korigod/clever-card/kicad/kicad.kicad_pcb

## KiCad design kicad/kicad.kicad_pcb (2019-04-13)

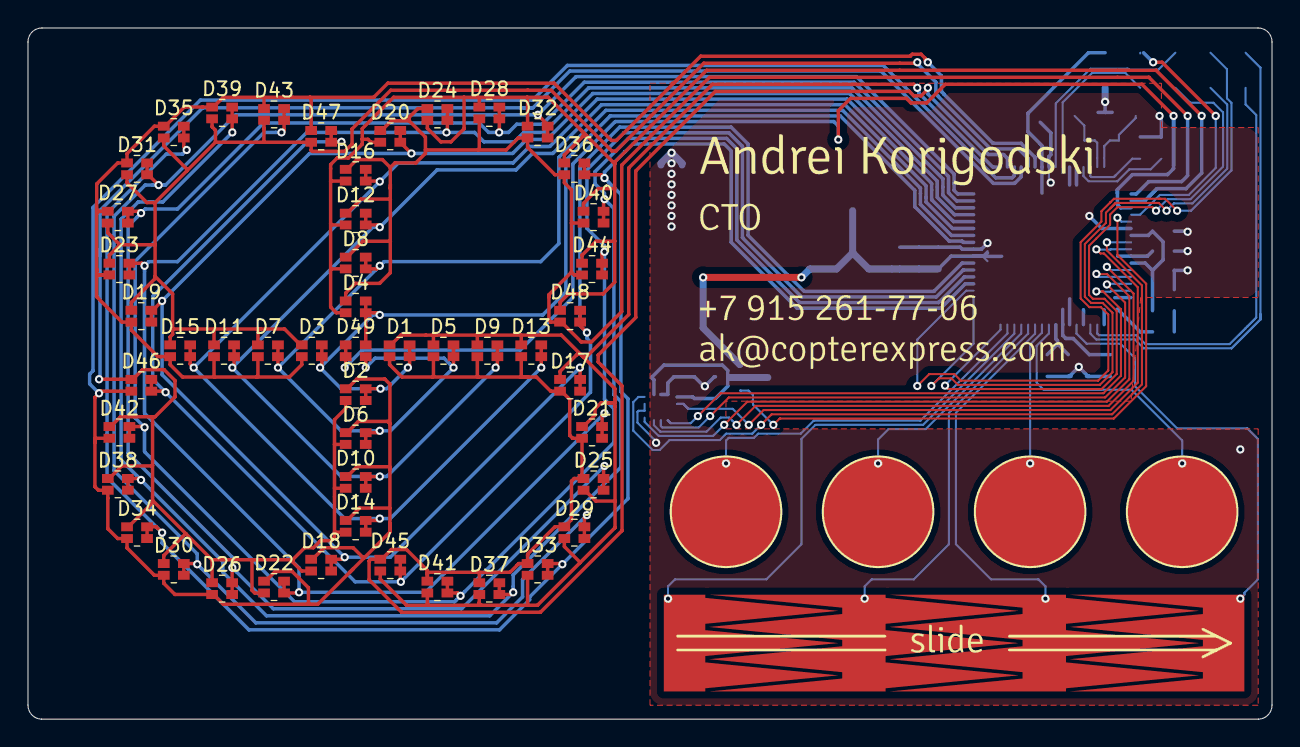
[picture p1: board kicad.kicad_pcb from above]

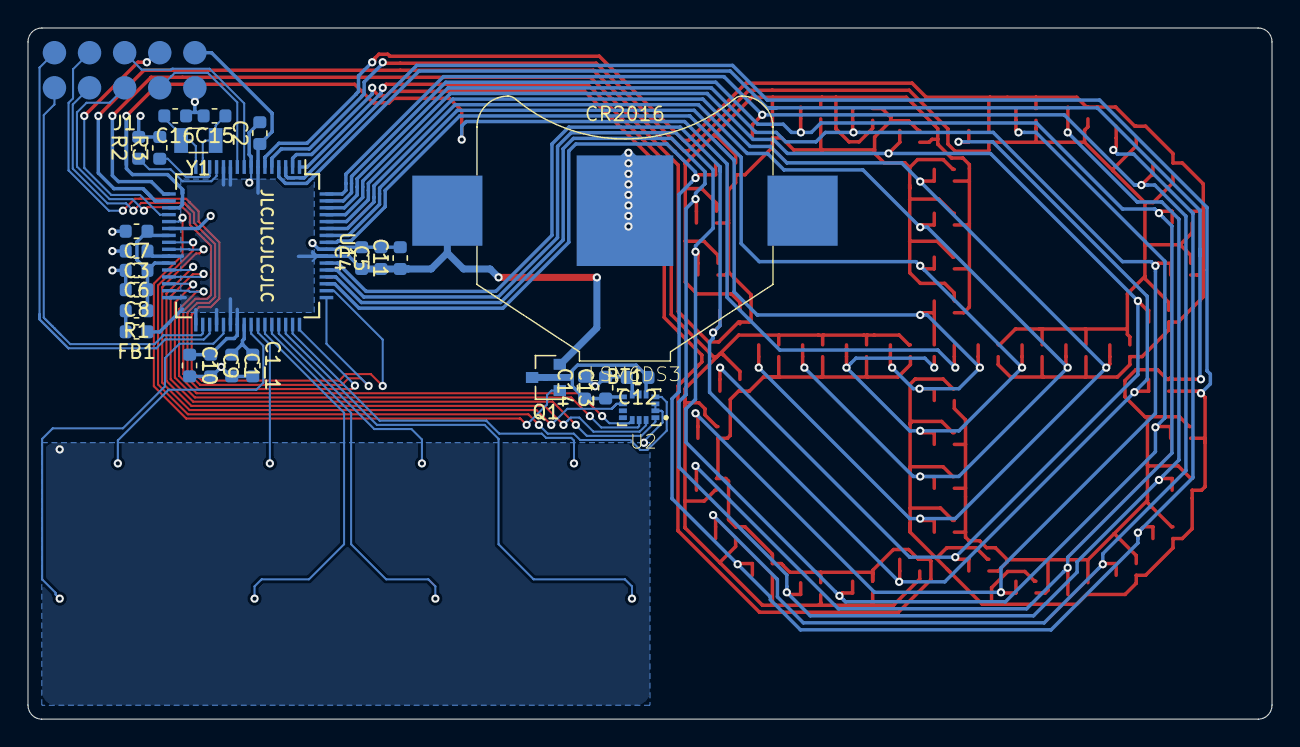
[picture p2: board kicad.kicad_pcb from below]

Board: 2 copper layers, 90.0 x 50.0 mm, 85 parts (27 on the bottom side), 54 nets.

Parts:
BT1: Battery_Cell; BatteryHolder_Keystone_3026_1x2016
C1, C5: 1uF; C_0603_1608Metric
C1_1, C8, C10, C14: 10uF; C_0603_1608Metric
C2, C3, C4, C9, C12, C13: 0.1uF; C_0603_1608Metric
C6, C7: 10nF; C_0603_1608Metric
C11: 47uF; C_0603_1608Metric
C15, C16: 22pF; C_0603_1608Metric
D1, D2, D3, D4, D5, D6, D7, D8, D9, D10, D11, D12, D13, D14, D15, D16, D17, D18, D19, D20, D21, D22, D23, D24, D25, D26, D27, D28, D29, D30, D31, D32, D33, D34, D35, D36, D37, D38, D39, D40, D41, D42, D43, D44, D45, D46, D47, D48, D49: LED_Dual_AACC; LED_DUAL_0606
FB1: Ferrite_Bead_Small; L_0603_1608Metric
J1: POGO_10PADS; TestPoints_2x05_P2.54_D1.7
Q1: Q_PMOS_GSD; SOT-23
R1: 1; R_0603_1608Metric
R2, R3: 0; R_0603_1608Metric
TS1, TS2, TS3, TS4: TOUCH_PAD; TouchPad_D8.0mm
TS5: TOUCH_SLIDER_4PADS; TouchSlider-4_42x7mm
U1: EFM32LG232F64; LQFP-64_10x10mm_P0.5mm
U2: LSM6DS3
Y1: 32768Hz; Crystal_SMD_3215-2Pin_3.2x1.5mm
svg2mod: G***; Text_Slide_Signika_Cu
svg2mod#2: G***; Text_Position_SilkS
svg2mod#3: G***; Text_Contacts_Reversed-2_SilkS
svg2mod#4: G***; Text_Name_without-i-dot_9.5pt_SilkS

Connections:
GND: BT1.2, C1.2, C1_1.2, C2.2, C3.2, C4.2, C5.2, C6.2, C7.2, C8.2, C9.2, C10.2, C11.2, C12.2, C13.2, C14.2, C15.2, C16.2, J1.2, R2.2, R3.2, U1.8, U1.22, U1.56, U2.2, U2.3, U2.6, U2.7
IMU_VDD: C12.1, C13.1, C14.1, Q1.3, U2.5, U2.8
LED_A0: D1.1, D5.1, D9.1, D13.1, D17.1, D21.1, D25.2, D29.2, D33.2, D37.2, D41.2, D45.2, U1.1
LED_A1: D1.2, D5.2, D9.2, D13.2, D17.2, D21.2, D25.1, D29.1, D33.1, D37.1, D41.1, D45.1, U1.2
LED_A2: D2.1, D6.1, D10.1, D14.1, D18.1, D22.1, D26.2, D30.2, D34.2, D38.2, D42.2, D46.2, U1.3
LED_A3: D2.2, D6.2, D10.2, D14.2, D18.2, D22.2, D26.1, D30.1, D34.1, D38.1, D42.1, D46.1, U1.4
LED_A4: D3.1, D7.1, D11.1, D15.1, D19.1, D23.1, D27.2, D31.2, D35.2, D39.2, D43.2, D47.2, U1.5
LED_A5: D3.2, D7.2, D11.2, D15.2, D19.2, D23.2, D27.1, D31.1, D35.1, D39.1, D43.1, D47.1, U1.6
LED_A6: D4.1, D8.1, D12.1, D16.1, D20.1, D24.1, D28.2, D32.2, D36.2, D40.2, D44.2, D48.2, U1.17
LED_A7: D4.2, D8.2, D12.2, D16.2, D20.2, D24.2, D28.1, D32.1, D36.1, D40.1, D44.1, D48.1, U1.18
LED_A8: D49.1, D49.2, U1.19
LED_K0: D1.3, D1.4, D2.3, D2.4, D3.3, D3.4, D4.3, D4.4, D49.3, U1.57
LED_K1: D5.3, D5.4, D6.3, D6.4, D7.3, D7.4, D8.3, D8.4, D49.4, U1.58
LED_K2: D9.3, D9.4, D10.3, D10.4, D11.3, D11.4, D12.3, D12.4, U1.59
LED_K3: D13.3, D13.4, D14.3, D14.4, D15.3, D15.4, D16.3, D16.4, U1.60
LED_K4: D17.3, D17.4, D18.3, D18.4, D19.3, D19.4, D20.3, D20.4, U1.61
LED_K5: D21.3, D21.4, D22.3, D22.4, D23.3, D23.4, D24.3, D24.4, U1.62
LED_K6: D25.3, D25.4, D26.3, D26.4, D27.3, D27.4, D28.3, D28.4, U1.63
LED_K7: D29.3, D29.4, D30.3, D30.4, D31.3, D31.4, D32.3, D32.4, U1.64
LED_K8: D33.3, D33.4, D34.3, D34.4, D35.3, D35.4, D36.3, D36.4, U1.51
LED_K9: D37.3, D37.4, D38.3, D38.4, D39.3, D39.4, D40.3, D40.4, U1.52
LED_K10: D41.3, D41.4, D42.3, D42.4, D43.3, D43.4, D44.3, D44.4, U1.53
LED_K11: D45.3, D45.4, D46.3, D46.4, D47.3, D47.4, D48.3, D48.4, U1.54
LFXTAL_N: C16.1, U1.16, Y1.2
LFXTAL_P: C15.1, U1.15, Y1.1
MCU_AVDD: C6.1, C7.1, C8.1, R1.2, U1.23, U1.27
unnamed: C1.1, C1_1.1, U1.40
unnamed: FB1.2, R1.1
unnamed: J1.3, U1.20
unnamed: J1.4, U1.10
unnamed: J1.5, U1.9
unnamed: J1.6, U1.48
unnamed: J1.7, U1.50
unnamed: J1.8, U1.49
unnamed: J1.9, U1.35
unnamed: J1.10, U1.34
unnamed: Q1.1, U1.21
unnamed: U1.29, U2.1
unnamed: U1.28, U2.14
unnamed: U1.30, U2.13
unnamed: U1.31, U2.12
unnamed: U1.24, U2.4
unnamed: U1.25, U2.9
unnamed: TS5.1, U1.46
unnamed: TS5.2, U1.44
unnamed: TS5.3, U1.43
unnamed: TS5.4, U1.37
unnamed: R2.1, U1.13
unnamed: R3.1, U1.14
TOUCH_PAD0: TS1.1, U1.47
TOUCH_PAD1: TS2.1, U1.45
TOUCH_PAD2: TS3.1, U1.42
TOUCH_PAD3: TS4.1, U1.41
VDD: BT1.1, C2.1, C3.1, C4.1, C5.1, C9.1, C10.1, C11.1, FB1.1, J1.1, Q1.2, U1.7, U1.11, U1.12, U1.26, U1.32, U1.33, U1.36, U1.38, U1.39, U1.55
