korigod/clever-card/test-jig/layout/test-jig.kicad_pcb

## KiCad design test-jig/layout/test-jig.kicad_pcb (2020-01-29)

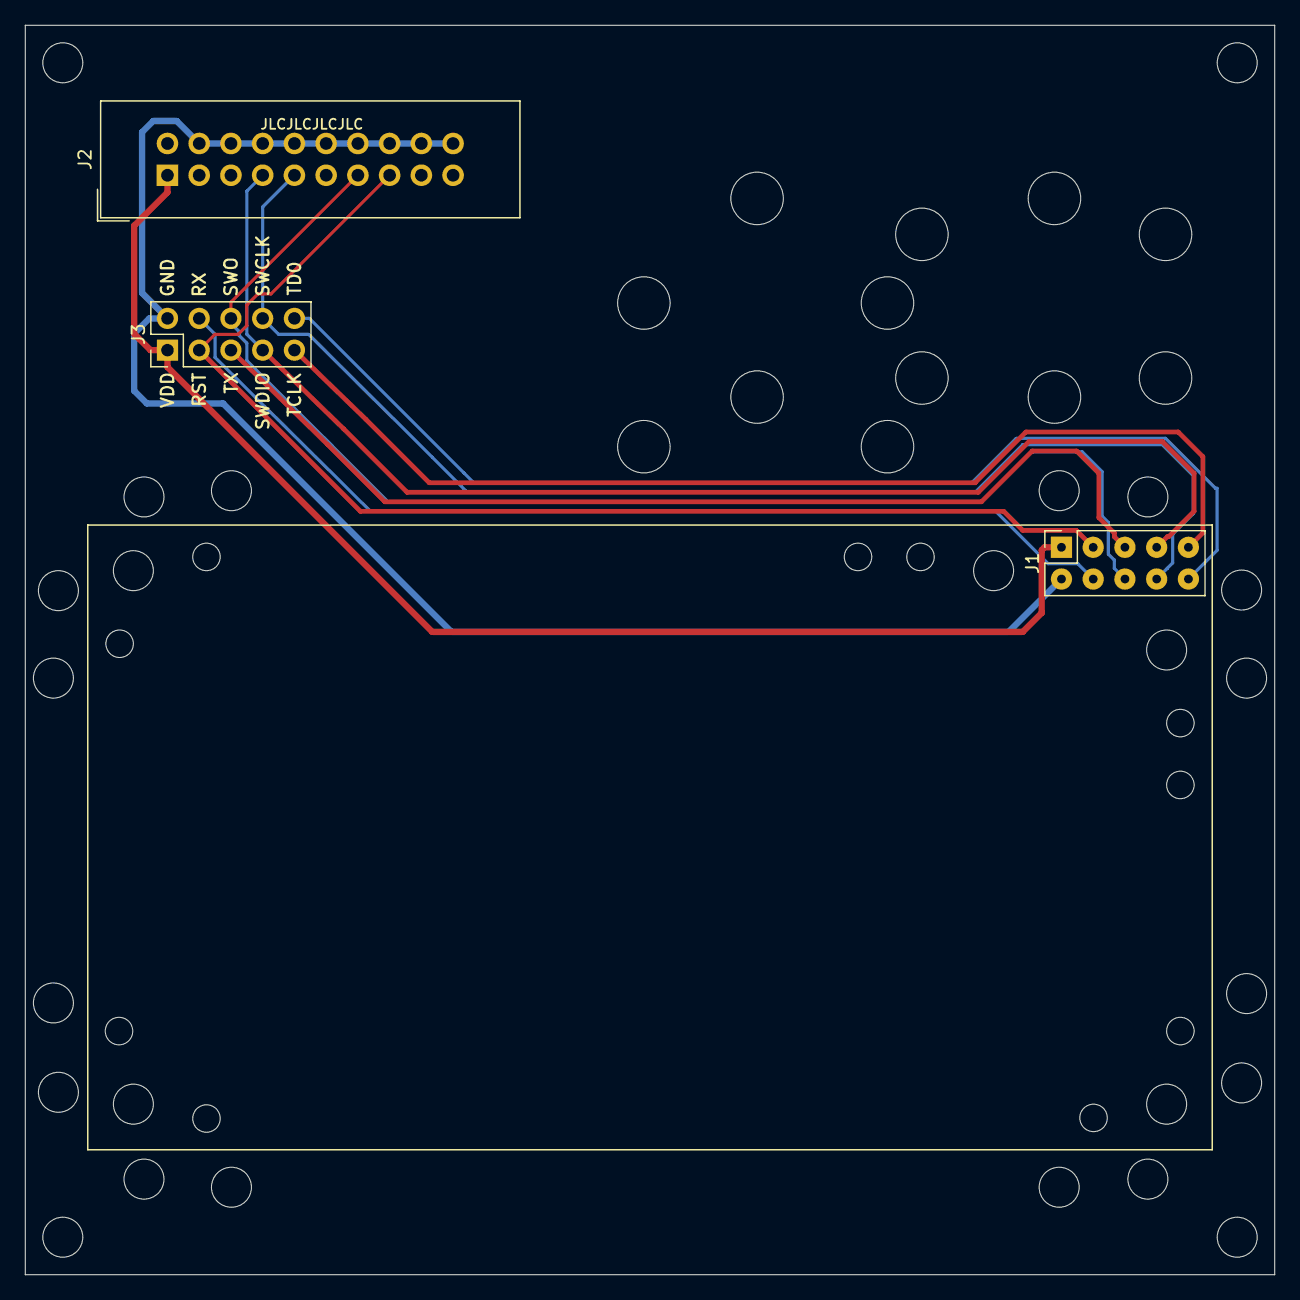
[picture p3: board test-jig.kicad_pcb from above]

Board: 2 copper layers, 100.0 x 100.0 mm, 3 parts (0 on the bottom side), 10 nets.

Parts:
J1: Conn_02x05_Odd_Even; PinHeader_2x05_P2.54mm_D0.7mm_Vertical
J2: Conn_02x10_Odd_Even; IDC-Header_2x10_P2.54mm_Vertical
J3: Conn_02x05_Odd_Even; PinHeader_2x05_P2.54mm_Vertical

Connections:
DBG_SWCLK: J1.8, J2.9, J3.8
DBG_SWDIO: J1.7, J2.7, J3.7
DBG_SWO: J1.6, J2.13, J3.6
ETM_TCLK: J1.9, J3.9
ETM_TD0: J1.10, J3.10
GND: J1.2, J2.4, J2.6, J2.8, J2.10, J2.12, J2.14, J2.16, J2.18, J2.20, J3.2
RESET: J1.3, J2.15, J3.3
USART_RX: J1.4, J3.4
USART_TX: J1.5, J3.5
VDD: J1.1, J2.1, J3.1
