korigod/clever-card/firmware/src/debug_hooks.c

#include "FreeRTOS.h"
#include "task.h"

#define TASK_STATUSES_ARRAY_SIZE 8

TaskStatus_t taskStatuses[TASK_STATUSES_ARRAY_SIZE];

void vApplicationIdleHook(void) {
	uxTaskGetSystemState(taskStatuses, TASK_STATUSES_ARRAY_SIZE, NULL);
}

void vApplicationStackOverflowHook(TaskHandle_t xTask, signed char *pcTaskName) {
	configASSERT(0);
}

void vApplicationMallocFailedHook(void) {
	configASSERT(0);
}

__attribute__((weak)) void vApplicationTickHook(void) {
	// This hook is redefined when testing on target device
}
