korigod/clever-card/firmware/src/static_alloc.c

#include "FreeRTOSConfig.h"
#include "FreeRTOS.h"


/* configSUPPORT_STATIC_ALLOCATION is set to 1, so the application must provide an
implementation of vApplicationGetIdleTaskMemory() to provide the memory that is
used by the Idle task. */
void vApplicationGetIdleTaskMemory(StaticTask_t **ppxIdleTaskTCBBuffer,
                                   StackType_t **ppxIdleTaskStackBuffer,
                                   uint32_t *pulIdleTaskStackSize)
{
	static StaticTask_t xIdleTaskTCB;
	static StackType_t uxIdleTaskStack[configMINIMAL_STACK_SIZE];

	*ppxIdleTaskTCBBuffer = &xIdleTaskTCB;
	*ppxIdleTaskStackBuffer = uxIdleTaskStack;
	*pulIdleTaskStackSize = configMINIMAL_STACK_SIZE;
}


/* configSUPPORT_STATIC_ALLOCATION and configUSE_TIMERS are both set to 1, so the
application must provide an implementation of vApplicationGetTimerTaskMemory()
to provide the memory that is used by the Timer service task. */
void vApplicationGetTimerTaskMemory(StaticTask_t **ppxTimerTaskTCBBuffer,
                                    StackType_t **ppxTimerTaskStackBuffer,
                                    uint32_t *pulTimerTaskStackSize)
{
	static StaticTask_t xTimerTaskTCB;
	static StackType_t uxTimerTaskStack[configTIMER_TASK_STACK_DEPTH];

	*ppxTimerTaskTCBBuffer = &xTimerTaskTCB;
	*ppxTimerTaskStackBuffer = uxTimerTaskStack;
	*pulTimerTaskStackSize = configTIMER_TASK_STACK_DEPTH;
}
