korigod/clever-card/(commit log)

2019-03-18 schematics: initial revision
2019-03-18 led_pattern_gen: initial revision
2019-03-22 schematics: update card
2019-03-22 footprints: add red-green dual LED
2019-03-22 schematics: decouple MCU and use red-green LEDs
2019-03-23 schematics: connect power to MCU
2019-03-23 schematics: generate LED matrix
2019-03-24 schematics: check if specified LED count achieved
2019-03-24 schematics: add capacitive touch pads
2019-03-24 schematics: add IMU power connections
2019-03-24 pins: add file with pin assignments
    [pins.csv]
2019-03-24 pins: separate pin and assignment with tabs
    [pins.csv]
2019-03-24 schematics: add 32768 Hz crystal
2019-03-24 schematics: add SPI and INT lines between MCU and IMU
    [pins.csv]
2019-03-24 pins: update pin assignment to add one more LED line
    [pins.csv]
2019-03-24 schematics: connect LED matrix to MCU
2019-03-24 schematics: use ERC (electrical rule check)
2019-03-25 schematics: suppress "Insufficient drive" ERC warning
2019-03-25 schematics: connect capacitive sense pads
2019-03-25 schematics: specify the crystal footprint
2019-03-25 schematics: add debug and programming interface
2019-03-25 schematics: specify correct footprint for battery holder
    It's fully compatible with Keystone 3028.
2019-03-25 schematics: update footprints according to KiCad 5 Device library
2019-03-26 footprints: add LSM6DS3
2019-03-27 footprints: rename LSM6DS3
2019-03-28 footprints: add touch slider generated by wizard
2019-03-28 gitignore: add kicad autosave files
2019-03-28 footprints: fix name of LSM6DS3
2019-03-28 schematics: fix LED footprint name
2019-03-29 schematics: connect unused EFM32 pins to circuit common
2019-03-29 footprints: add capacitive touch pad
2019-03-29 footprints: generate touch slider with my new python tool
2019-03-30 footprints: add debug/programming pads for spring loaded connector
2019-03-31 led_pattern: move matplotlib plotting and GUI to separate module
2019-04-01 led_pattern: rename led_pattern_gen to led_pattern
2019-04-01 led_pattern: improve readability
2019-04-01 led_pattern: fix calculations in case linear_radius != 1
2019-04-01 led_pattern: swap linear leds to make layout easier
2019-04-02 footprints: improve touch slider
2019-04-03 footprints: add new generated footprint for CR2016 holder
2019-04-03 schematics: modify LED connection
2019-04-03 schematics: swap touch slider pins to make layout easier
2019-04-03 led_pattern: fix LED arcs generation
2019-04-03 led_pattern: add pcbnew script for automated layout
2019-04-03 schematics: add oscillator load capacitors
2019-04-03 schematics: add larger IMU decoupling capacitor
2019-04-03 schematics: swap LED pins to simplify layout
2019-04-04 schematics: simplify MCU analog power decoupling
2019-04-04 schematics: connect unused pins to power instead of ground
    It makes layout easier
2019-04-06 schematics: assign names to crystal nets
    It enables KiCad differential pair length matching tools.
2019-04-06 schematics: pass ground net for unused IMU pins as arg
2019-04-06 schematics: fix unused pins handling message
2019-04-06 schematics: swap touch sense pins to make layout simpler
2019-04-06 schematics: add P-MOSFET to cut IMU power
    It consumes several uA even when disabled.
    [pins.csv]
2019-04-07 schematics: decouple MCU_AVDD better
    This reverts commit 16f4ae7.
2019-04-07 schematics: change IMU power mosfet pin
    [pins.csv]
2019-04-08 led_pattern: make compatible with python 2
    KiCad uses python 2.7.
2019-04-09 schematics: specify debug pads ref_prefix
2019-04-09 schematics: modify MCU power decoupling
2019-04-09 footprints: update battery holder footprint
2019-04-09 footprints: update LED footprint
2019-04-10 footprints: add silkscreen circle to touch button
2019-04-10 footprints: add touch button with circle in mask layer
2019-04-13 kicad: first manufactured revision
    [clever-JLC-label-silkscreen-placeholder.kicad_pcb, clever-for-gold-plating_all-text-on-mask.kicad_pcb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]
2019-04-14 BOM: first revision
    [BOM.csv]
2019-04-16 pins: remove outdated pin assignment doc
2019-04-16 components: remove unused RGB led
2019-07-05 firmware-experimental: first revision of LSM6DS3 test project
    EFM32LG-STK3600 dev board is used.
2019-07-06 firmware-experimantal: use DMA for SPI transfer
2019-07-07 pins: clarify the assignment
    IMU_FET is the gate of the N-MOSFET which cuts LSM6DS3's power
    when it's not in use to minimize power consumption.
    [pins.csv]
2019-07-07 led_pattern: fix variables names
2019-07-08 firmware: remove LED-control test code
2019-07-08 firmware: update statuses of tasks in idle hook
    It's useful for debugging, but introduces jitter in task arbitration and
    delay times. It looks like the update takes up to one millisecond. Maybe
    it would be better to move it to a separate task and call it less
    frequently.
    [debug_hooks.c]
2019-07-08 firmware: use GPIO interrupt to initiate IMU query
2019-07-08 firmware: use INT1 pin of LSM6DS3 for Data Ready IRQ
2019-07-09 firmware: enable a timer for debug purposes
2019-07-09 firmware: use task notification to trigger IMU query
    The problem with direct triggering from ISR is that all the tasks can
    be starved of processing time if the data is being transfered all the
    time — e.g. when IMU update rate is very high or when the debugger is
    used to pause the execution (the IMU itself is not being paused and
    it looks for the firmware like IMU is constantly triggering DRDY line
    even although the last measurement is not processed yet).
    [gpio_irq.c, gpio_irq.h, imu.c, imu.h, main.c]
2019-07-09 firmware: use angular rate sensor
2019-07-09 firmware: use hardware timer to implement µs delay
2019-07-09 firmware: rewrite delayMicroseconds to support longer delays
    Now it supports delays up to 5 minutes, though it is definitely not
    a good idea to use it like that.
    Also previous version had a problem when delay is close to USHRT_MAX,
    it could run for several more timer periods before break.
    [timer.c, timer.h]
2019-07-09 firmware: fix SPI communication on low baudrates
    It looks like if we send commands without delay on low baudrate
    (100kbps or less), the hardware CS control does not deassert the line
    so the transmission is corrupted and the LSM6DS3 does not start.
    [imu.c, imu.h]
2019-07-09 firmware: move writing to IMU registers to separate function
2019-07-09 firmware: rewrite timer module
    Now it provides absolute time with microsecond granularity
    instead of just blocking delays.
2019-07-09 firmware: throttle IMU queries a bit
2019-07-09 firmware: reduce size of DMA control block
    It must be increased if more DMA channels are used.
2019-07-11 firmware: first revision of LED control
    Here a LED is switched on by the task and switched off by the timer ISR.
    Additional software triggered interrupt is used to notify the task
    because the priority of the first interrupt should be the highest to
    minimize LED brightness jitter.
    The disadvantage of such an approach is that both the minimal LED on
    time (6 μs @ 14 MHz) and the LED control cycle time (60 μs) are quite
    high, mainly due to FreeRTOS task switching latencies.
    [gpio_irq.c, gpio_irq.h, leds.c, leds.h, main.c, timer.c, timer.h]
2019-07-11 firmware: toggle leds inside the ISR
    This way the context switching delays are minimized. Minimal control
    cycle time for a single LED is now just 8 μs, and the minimal LED on
    time is decreased to 3 μs.
    The downside is the increase of the interrupt latency. However, now
    there are no more such time-sensitive tasks and if they appear, the
    priority of the timer interrupt can be decreased. This, of course,
    will introduce more significant LED on time jitter.
    [gpio_irq.c, gpio_irq.h, leds.c, leds.h, main.c, timer.c, timer.h]
2019-07-13 firmware: use separate list of LED IDs
2019-08-06 firmware: create leds module
2019-08-06 firmware: move board-specific values to separate header file
2019-08-06 firmware: specify LED cathodes
2019-08-06 firmware: clarify LED initializing
2019-08-06 firmware: add functions to switch LED anodes
2019-08-06 firmware: add function to disable LEDs
2019-08-06 firmware: add functions to control LED cathodes
2019-08-07 firmware: rename leds module to led_driver
2019-08-07 firmware: move LED pin structs to new module
2019-08-07 firmware: rename led driver test
2019-08-07 firmware: fix an include
    [board.h]
2019-08-08 schematics: add a comment
2019-08-08 firmware: add array of LED cathodes and anodes
2019-08-08 firmware: add array of LED output values
2019-08-08 firmware: add constant for number of leds
    It's for number of junctions (red and green separately), not packages.
2019-08-10 firmware: rename LedWires to LedPins
2019-08-10 firmware: add function to switch on next LED
2019-08-10 firmware: use defines for LED count
    Because in C consts are not constant expressions.
2019-08-10 firmware: fix initialization of LED pins array
    [board.h]
2019-08-11 firmware: separate LED preparation and switching on
2020-01-27 firmware: make led driver more robust
    Now only one anode pin is active at a time. It prevents short curcuit
    if two anode lines are connected by dirt or moisture — anode pads are
    close to each other at every LED.
    [led_driver.c, test_led_driver.c, test_leds.c]
2020-01-27 firmware: latch LED outputs every LED update loop
2020-01-27 firmware-experimental: fix includes order
    [timer.c]
2020-01-28 firmware-experimental: add SWO printf example
2020-01-29 test-jig: first revision of the layout
    [test-jig.kicad_pcb]
2020-01-29 test-jig: first revision of schematics
2020-01-29 test-jig: route the traces
    [test-jig.kicad_pcb]
2020-01-29 test-jig: create gerbers for pcb production
    [test-jig-B_Cu.gbr, test-jig-B_Mask.gbr, test-jig-B_Paste.gbr, test-jig-B_SilkS.gbr, test-jig-Edge_Cuts.gbr, test-jig-F_Cu.gbr, test-jig-F_Mask.gbr, test-jig-F_Paste.gbr]
2020-01-29 schematics: fix
2020-01-29 schematics: move component files to schematics dir
2020-01-30 firmware: add gamma=2 to led brightness control
2020-01-30 firmware: add timer module and manage leds with it
2020-01-30 firmware: don't latch led outputs every update cycle
    The values can be only partially updated by update task.
2020-01-30 firmware: make ledOutputs array public
    It's ok to change them and leave in inconsistent state because they are
    being latched anyway. Unfortunately, because we declare this array now
    without defining its length, vscode doesn't show array content in
    debugger. It can be fixed by including board.h, but it requires to move
    declaration of led structs to a new file to prevent circular dependency
    between board.h and led.h.
    [leds.h]
2020-01-30 firmware: add function to clear ledOutputs buffer
2020-01-30 firmware: don't disable led update cycle when all leds are off
2020-01-30 firmware: add FreeRTOS task to control leds
2020-01-30 firmware: traverse nicely through all the leds
2020-01-30 firmware: traverse nicely and smoothly through all the leds
2020-01-30 firmware: add utterly cool led effects
2020-02-01 firmware: add test to detect short circuits on PCB
    Test functions return on the first short circuit detected.
    [test_short_circuit.c]
2020-02-02 firmware: improve short circuit test
    [test_short_circuit.c]
2020-02-02 firmware: report all short circuits instead of the first one
    Parameterized tests are supported quite poorly in Unity/Ceedling.
    Alternatives may include:
    - generating test .c file by custom script;
    - generating runner by custom script instead of ceedling.
    [test_short_circuit.c]
2020-02-03 firmware: don't stop listening to SWO on test failure
    [run_test_on_target.py]
2020-02-03 firmware: check led update time utilization
2020-02-04 firmware: refine timer's minimal interval
2020-02-04 firmware: check timer's actual min delay duration
2020-02-04 firmware: calculate timer overhead (additionally waited ticks)
2020-02-04 firmware: fix led update issues
    [led_control.c, leds.c]
2020-08-18 firmware-experimental: fix interrupt priority
    NVIC_SetPriority accepts unshifted priority value (and shifts it itself)
    [imu.c]
2020-08-18 firmware: make test exec time measurement FreeRTOS-compatible
    Now milliseconds value increments in SysTick handler if it's not
    provided by FreeRTOS or in FreeRTOS tick hook otherwise.
2020-08-18 firmware: initial revision of LSM6DS3 IMU driver and tests
2020-08-18 firmware: add LSM6DS3 driver to Makefile
2020-08-18 firmware: add RTOS task to query IMU
2020-08-18 firmware: don't compile FreeRTOS for tests
    Ceedling compiles FreeRTOS if it's in source paths and then we get multiple
    definition error when we are trying to mock FreeRTOS functions.
    Another workaround may be to use fff plugin (#include "mock_queue.h"...) but
    I'm not sure it will work because other header files are including queue.h.
    [test_lsm6ds3.c]
2020-08-18 firmware: add default suiteTearDown for testing on target
    This serves two purposes: we can use leds to check if test passes and
    we circumvent a problem with suiteTearDown — for some weird reason
    when all the tests in directory are run using test:path directive,
    suiteTearDown is being included in the test runner even if it's
    absent in the file.
    [test_lsm6ds3.c]
2020-08-18 firmware: add tests for IMU RTOS task
